kgalinec/macro-pad/production/Macro_Pad/Transcode Report.txt

   ---- Transcoding 'D:\Nextcloud\Electronics\KiCad\Macro Pad\production\Macro_Pad\Macro Pad-PTH.drl' ----   Thu Jun 26 19:38:50 2025

T2   --> T11
T8   --> T12
-----------------------------------------------------------------
