kgalinec/macro-pad/plots/Macro Pad__Assembly.pdf

ENC202 | ENC203 | H¹⁰¹ H201 | H202 H204 LED¹⁰² | LED¹⁰¹ | SW210 SW202 SW208 | SW203 SW205 | SW209 SW206 SW201 | SW207 SW204 1 | 2 | 3 | 4 | 5 | 6 1 | 2 | 3 | 4 | 5 | 6 ABCD | ABCD Date: KiCad | E.D.A. 9.0.2 Size: A4 | Rev:
ENC201 MountingHole_Pad H203 | HS91L02W2C01 OLED201 ENC202 | ENC203 | Header-Male⁻2.54_1x3 H¹⁰¹ MountingHole_Pad H202 MountingHole_Pad H201 | MountingHole_Pad H204 LED¹⁰² | LED¹⁰¹ | MX_Cherry SW210 MX_Cherry SW202 MX_Cherry SW208 | MX_Cherry SW203 MX_Cherry SW205 | MX_Cherry SW209 MX_Cherry SW206 MX_Cherry SW201 | MX_Cherry SW207 MX_Cherry SW204

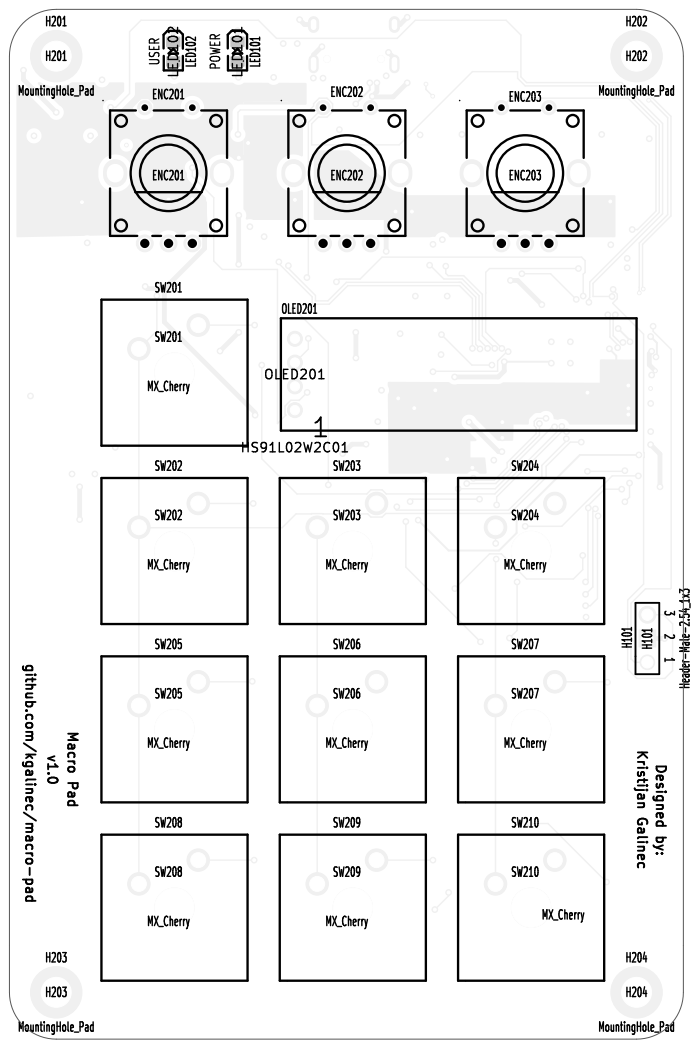
[picture p1: page 1]
Id: /1 Title: File: Macro; Pad.kicad_pcb Sheet: Black; And; White; TOP; Board2Pdf:; Black; TOP -; Page

3 2 1 Macro Pad v1.0 USER Kristijan Galinec github.com/kgalinec/macro-pad POWER Designed by: ENC201 H203 OLED2011

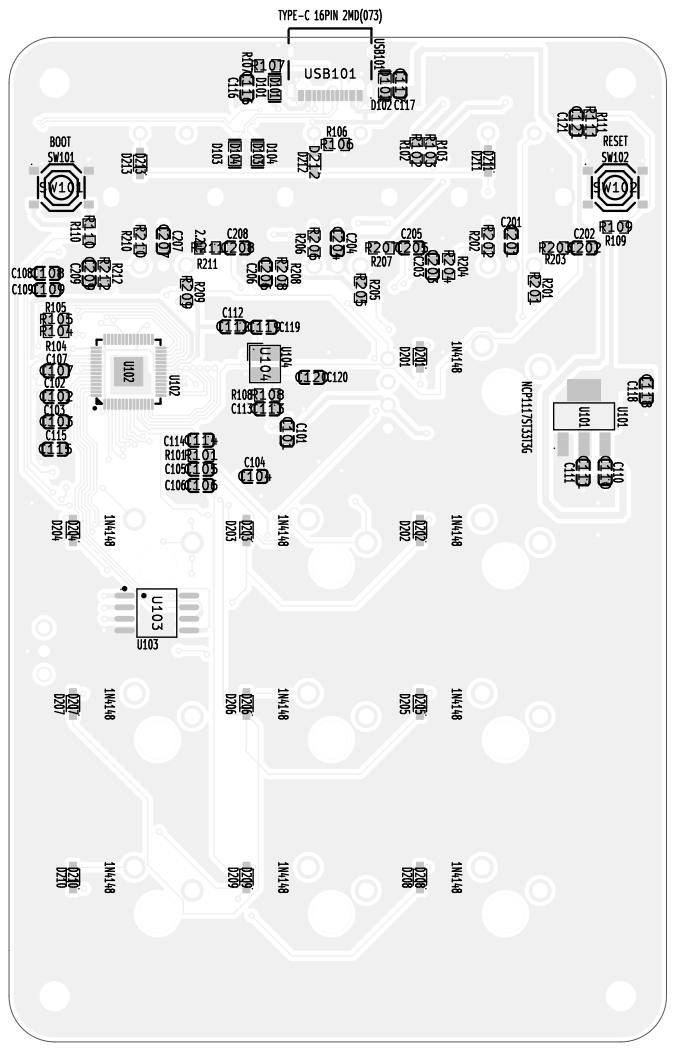
[picture p2: page 2]
