kgalinec/macro-pad/Macro Pad.pdf

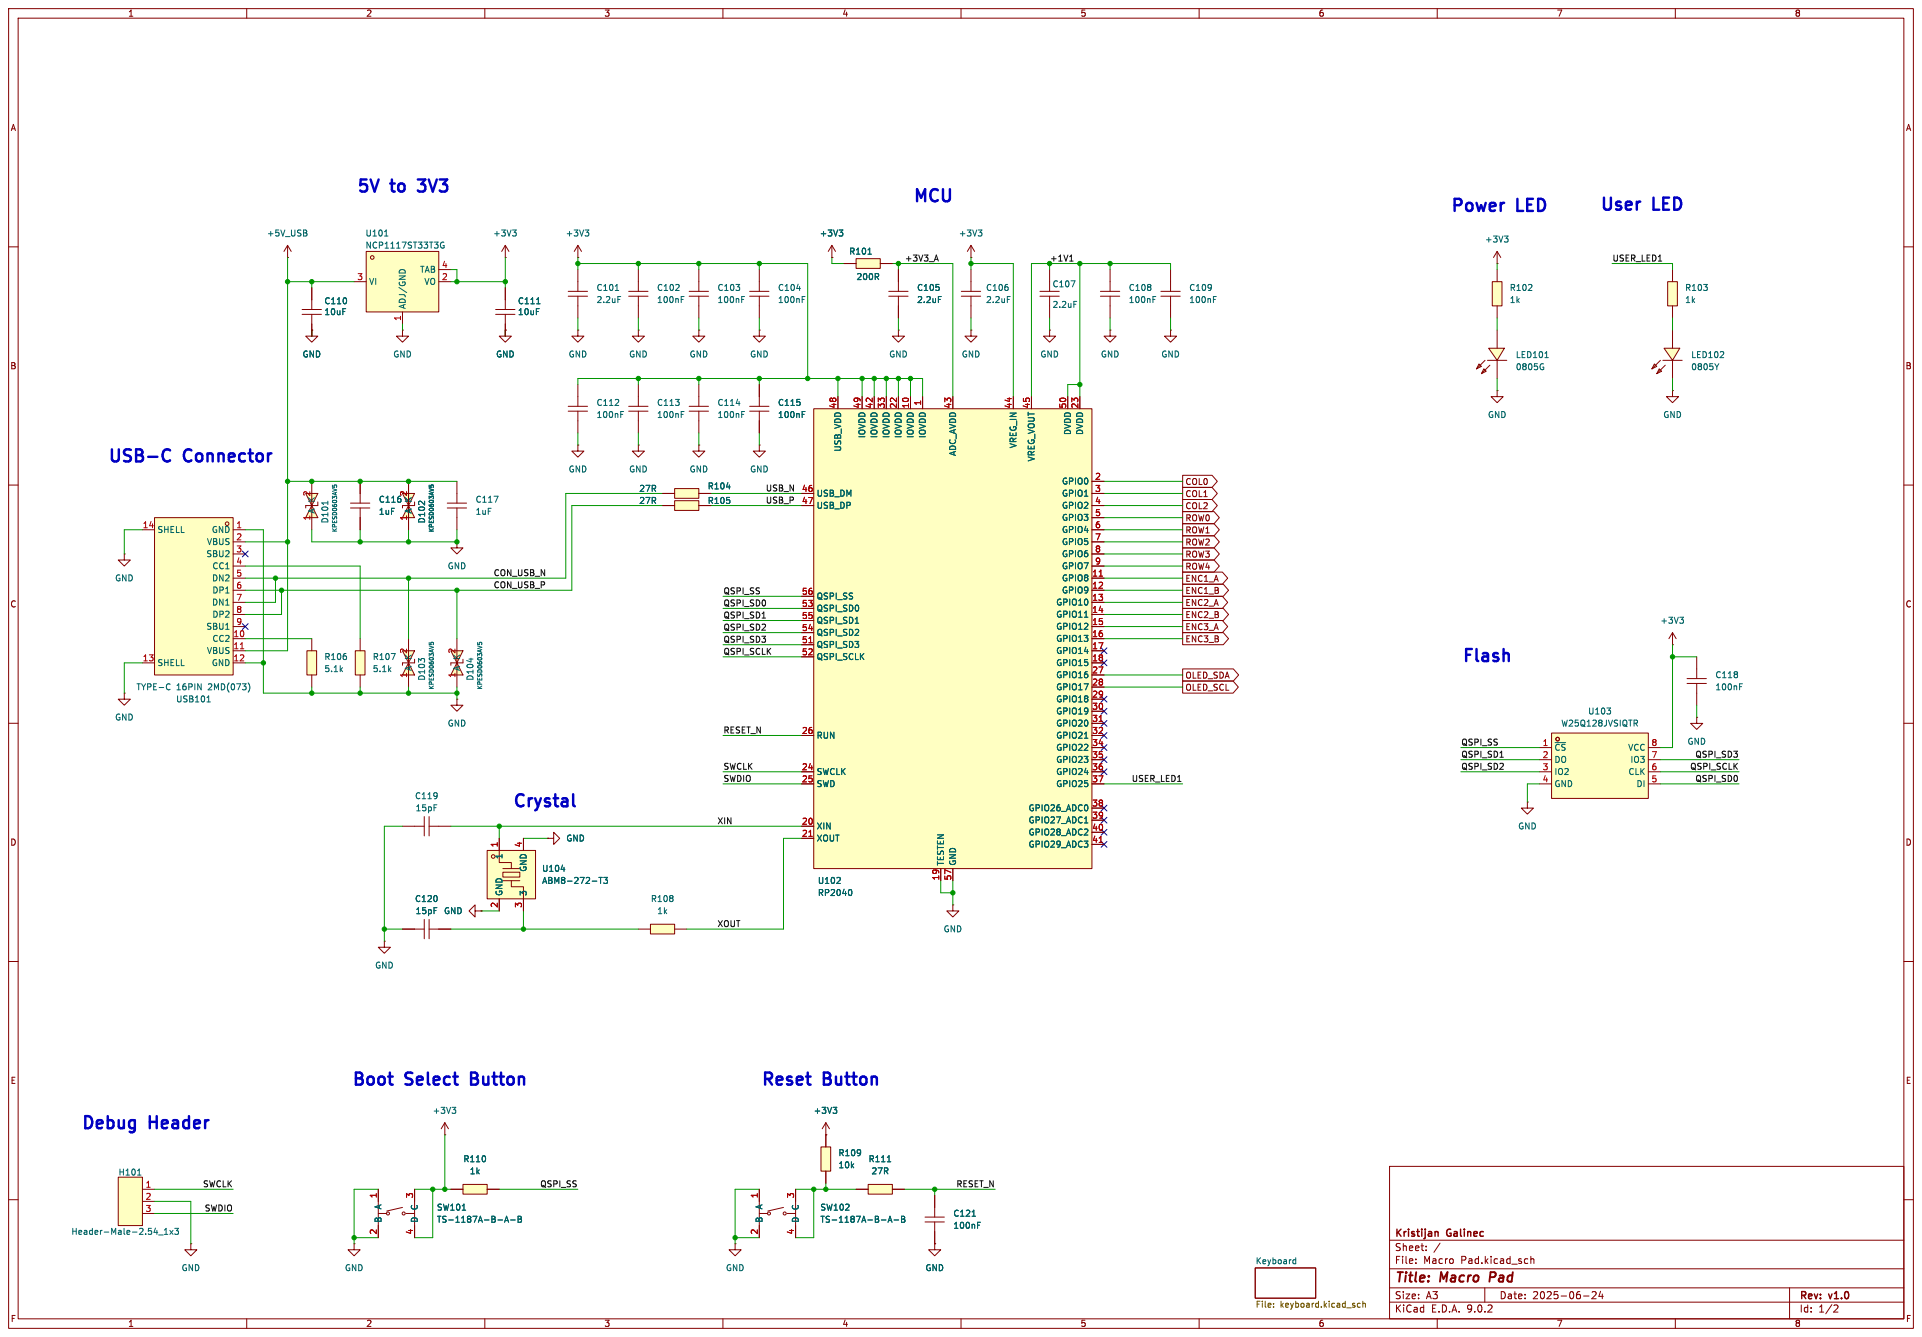
[picture p3: page 1]

1 TESTEN 19 ADC_AVDD 43 GND 57 VREG_IN 44 VREG_VOUT45 DVDD 50 DVDD 23 GPIO0 2 GPIO1 3 GPIO2 4 GPIO3 5 GPIO4 6 GPIO5 7 GPIO6 8 GPIO7 9 GPIO8 11 GPIO9 12 GPIO10 13 GPIO11 14 GPIO12 15 GPIO13 16 GPIO14 17 GPIO15 18 GPIO16 27 GPIO17 28 GPIO18 29 GPIO19 30 GPIO20 31 GPIO21 32 GPIO22 34 GPIO23 35 GPIO24 36 GPIO25 37 GPIO26_ADC0 38 GPIO27_ADC1 39 GPIO28_ADC2 40 GPIO29_ADC3 41 U102 RP2040

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

Id: 1/2 Title: Macro Pad

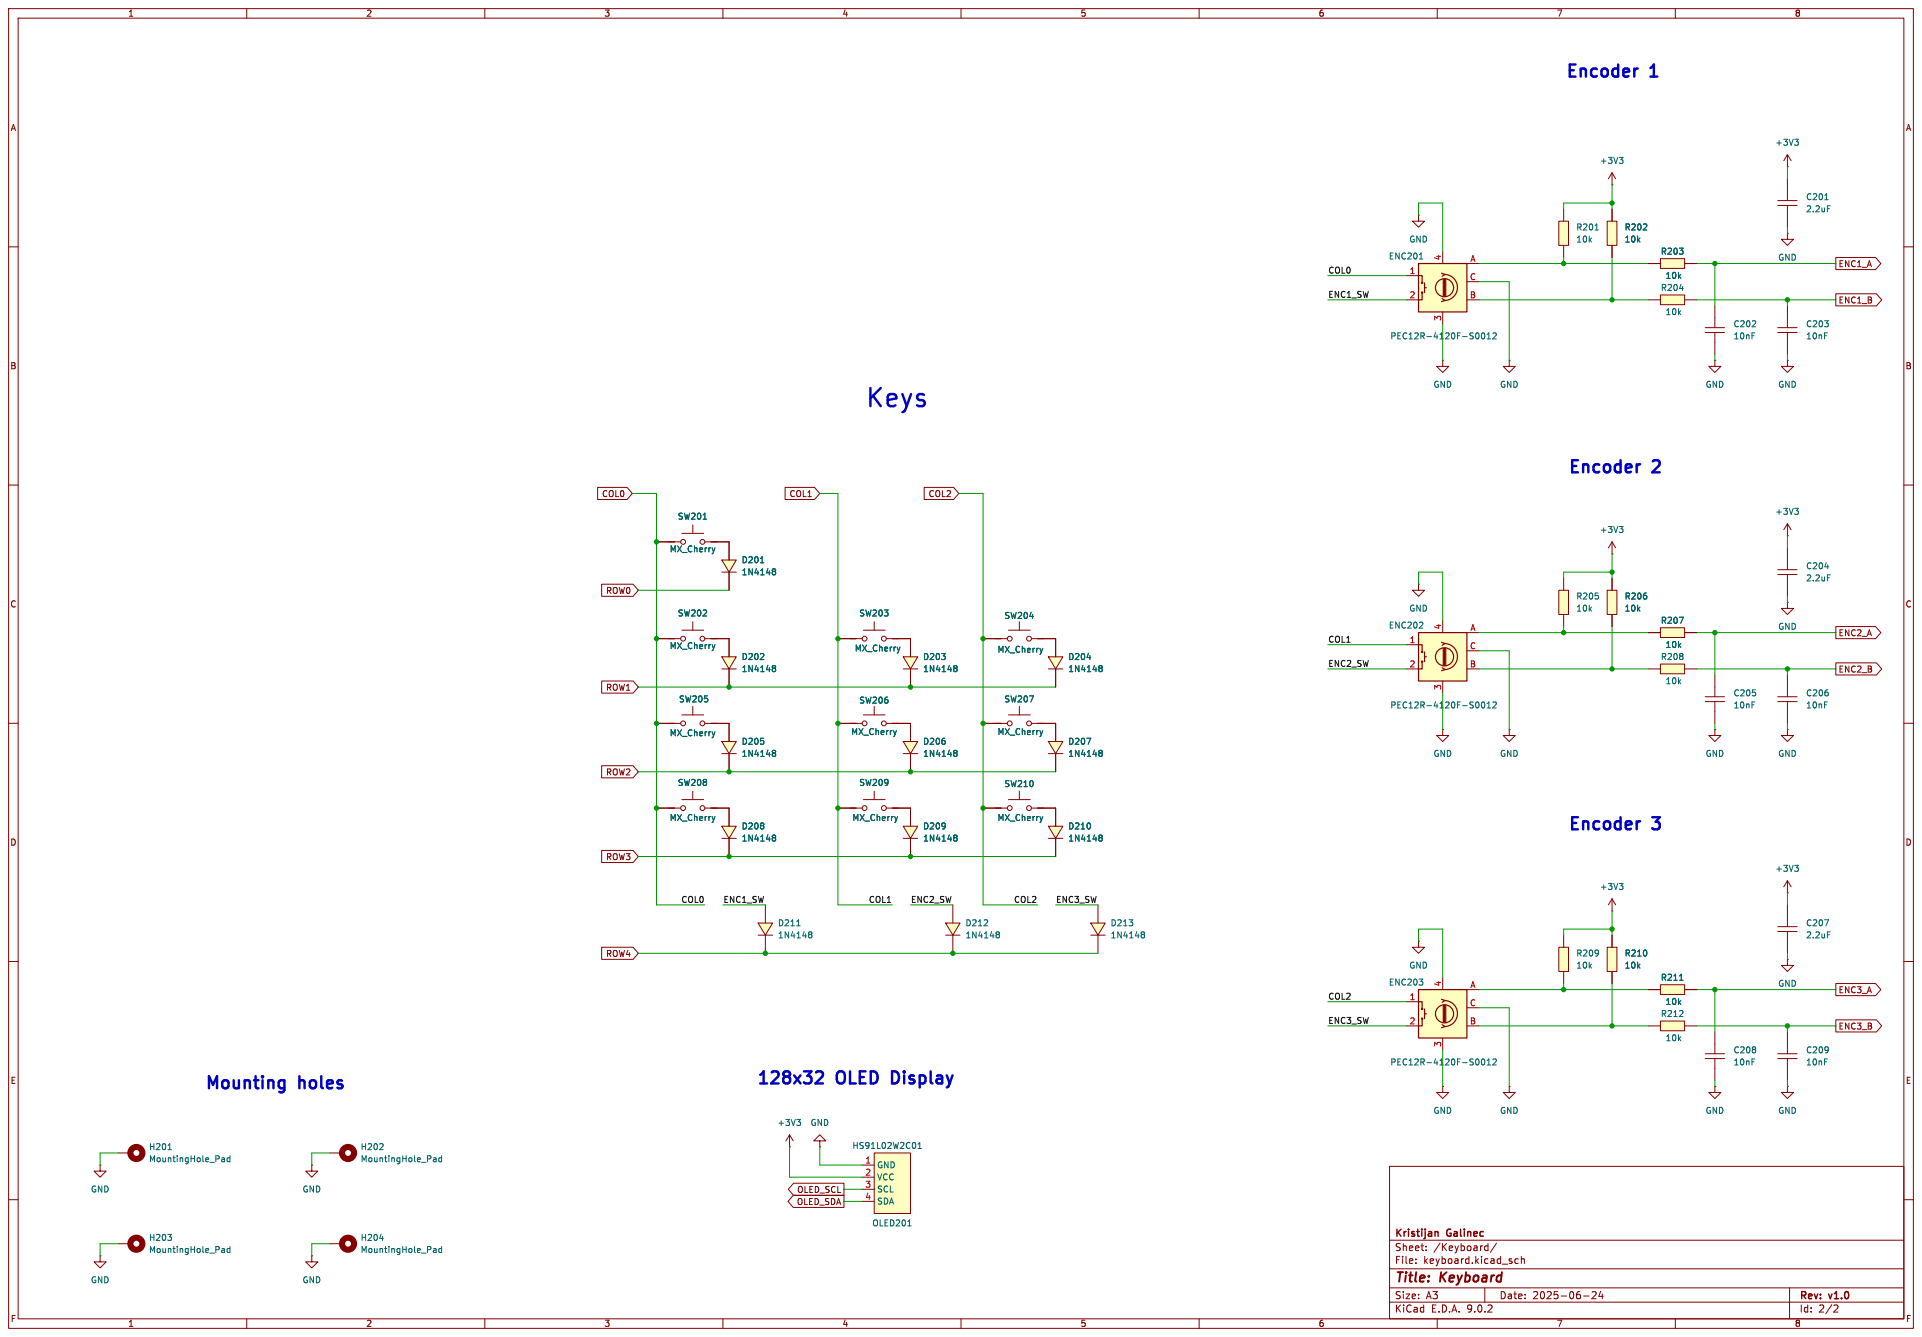
[picture p4: page 2]

SDA 4 SCL 3 VCC 2 GND 1 OLED201 HS91L02W2C01 GND
