kgalinec/macro-pad/Macro Pad-B_Cu.pdf

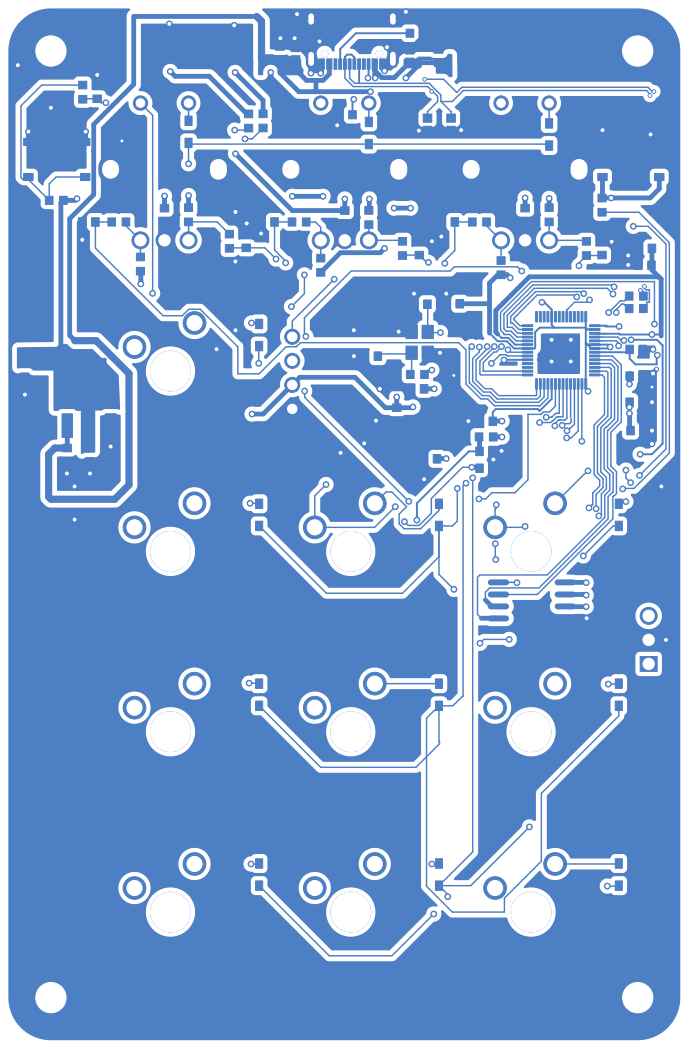
[picture p5: page 1]
