kgalinec/macro-pad/Macro Pad-B_Mask.pdf

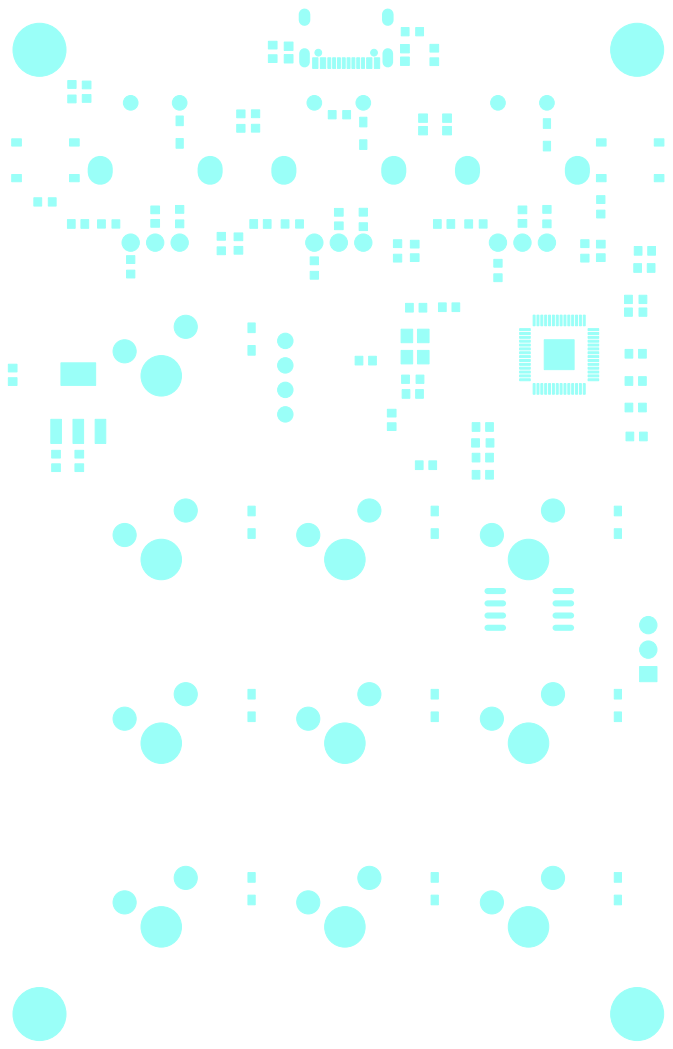
[picture p6: page 1]
