kgalinec/macro-pad/Macro Pad-B_Paste.pdf

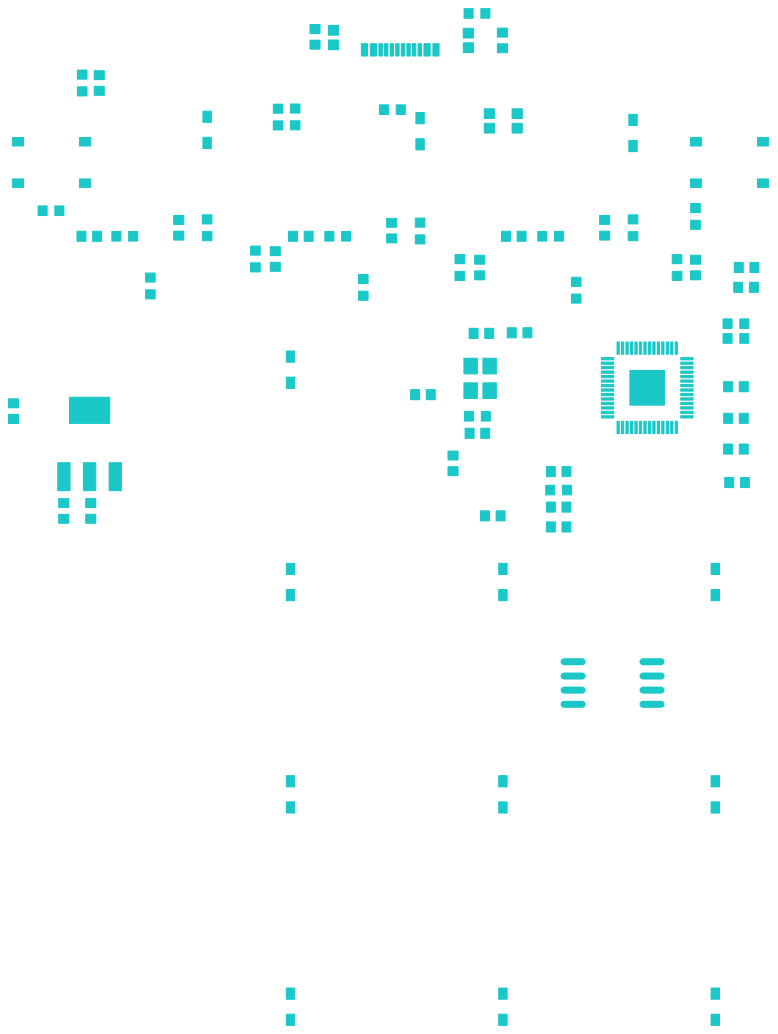
[picture p7: page 1]
