kgalinec/macro-pad/Macro Pad-B_Silkscreen.pdf

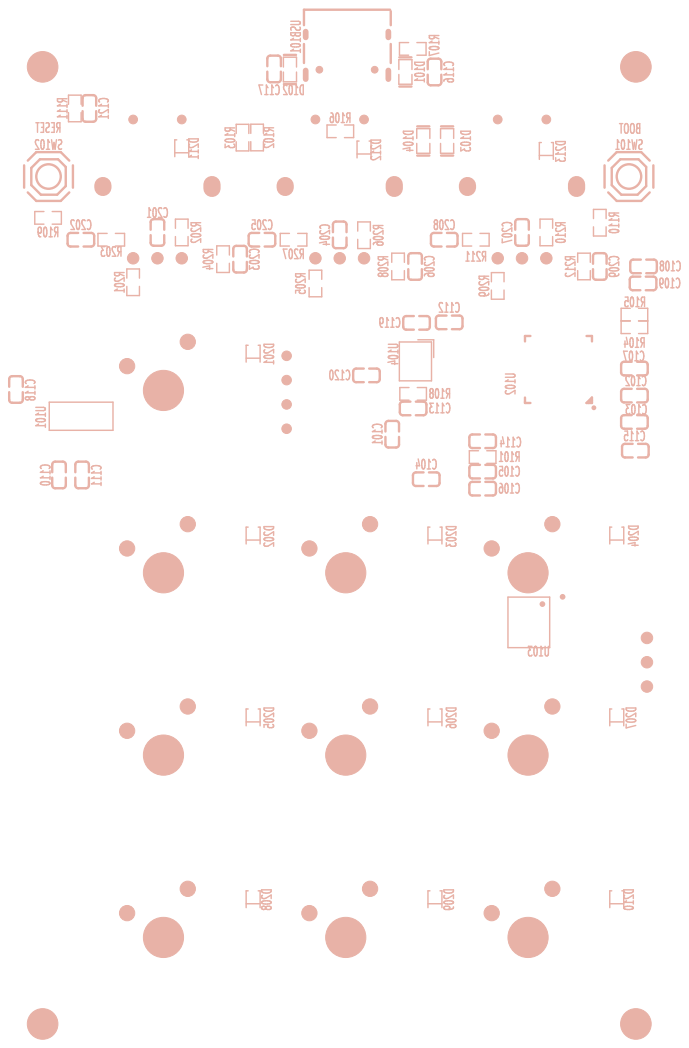
[picture p8: page 1]
