kgalinec/macro-pad/Macro Pad-Edge_Cuts.pdf

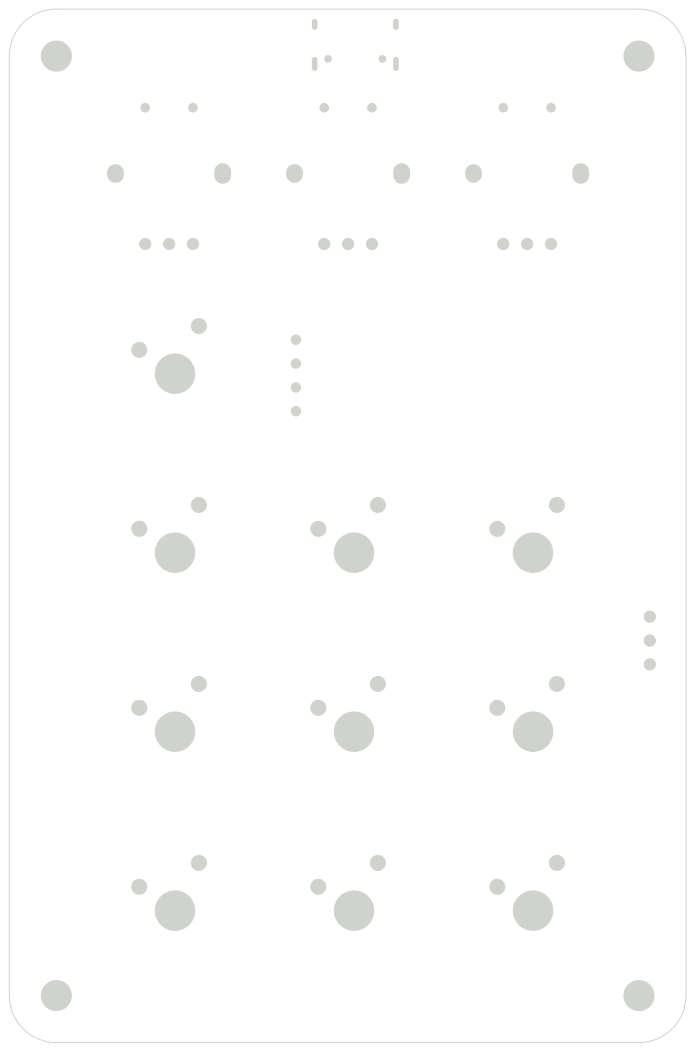
[picture p9: page 1]
