kgalinec/macro-pad/Macro Pad-F_Cu.pdf

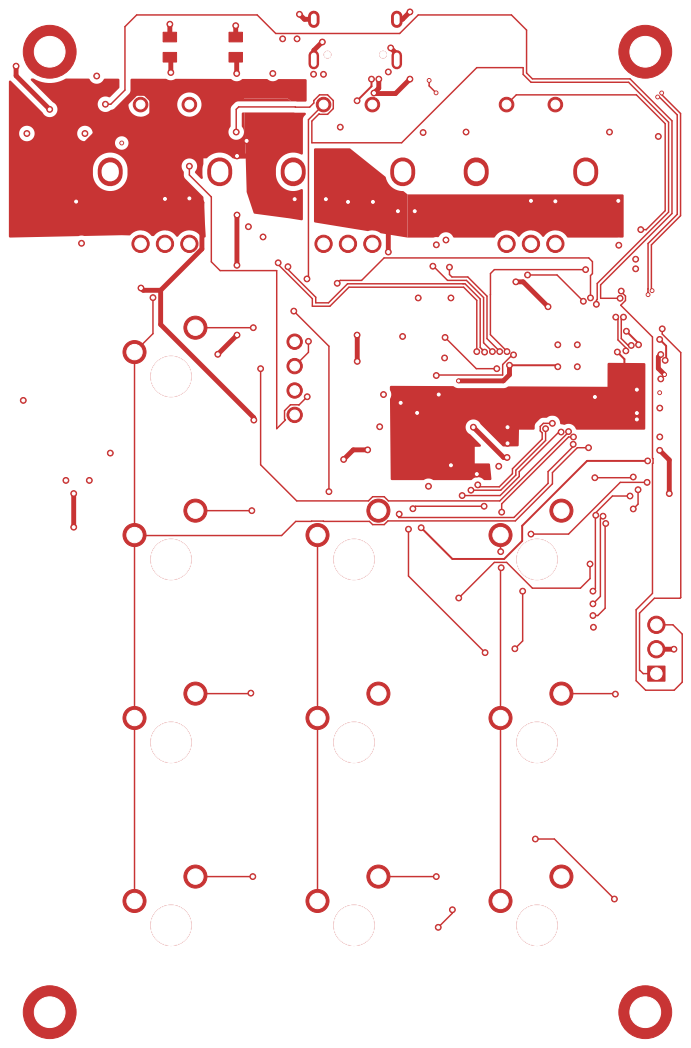
[picture p10: page 1]
