kgalinec/macro-pad/Macro Pad-F_Mask.pdf

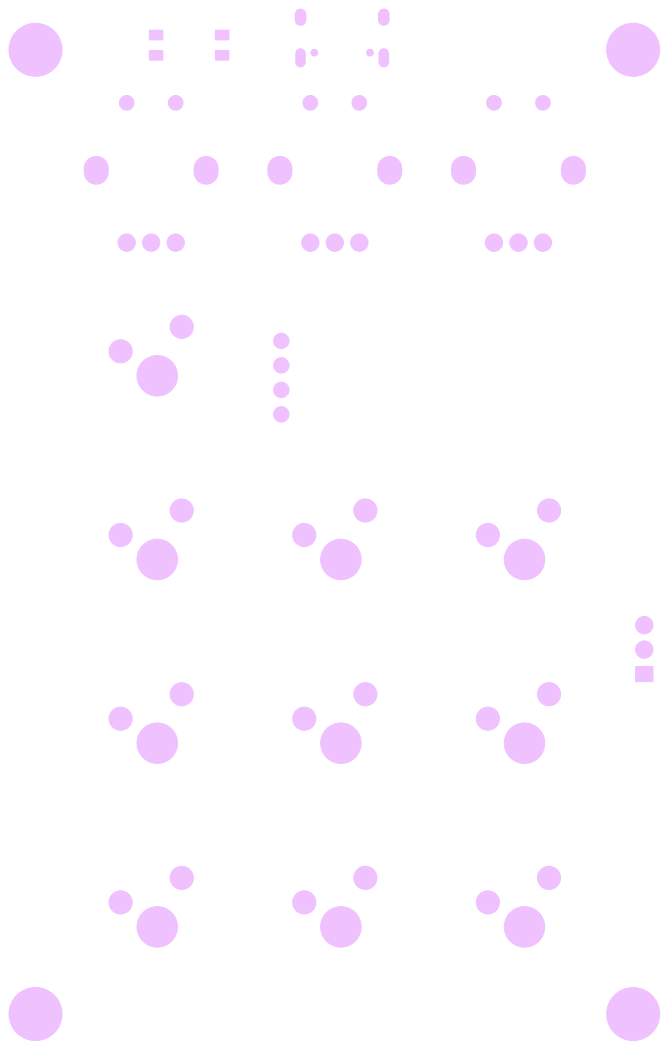
[picture p11: page 1]
