kgalinec/macro-pad/(list of files, drawings)

Other design files:
freerouting.dsn
