kgalinec/macro-pad/Macro Pad.kicad_pcb

## KiCad design Macro Pad.kicad_pcb (2026-02-02)

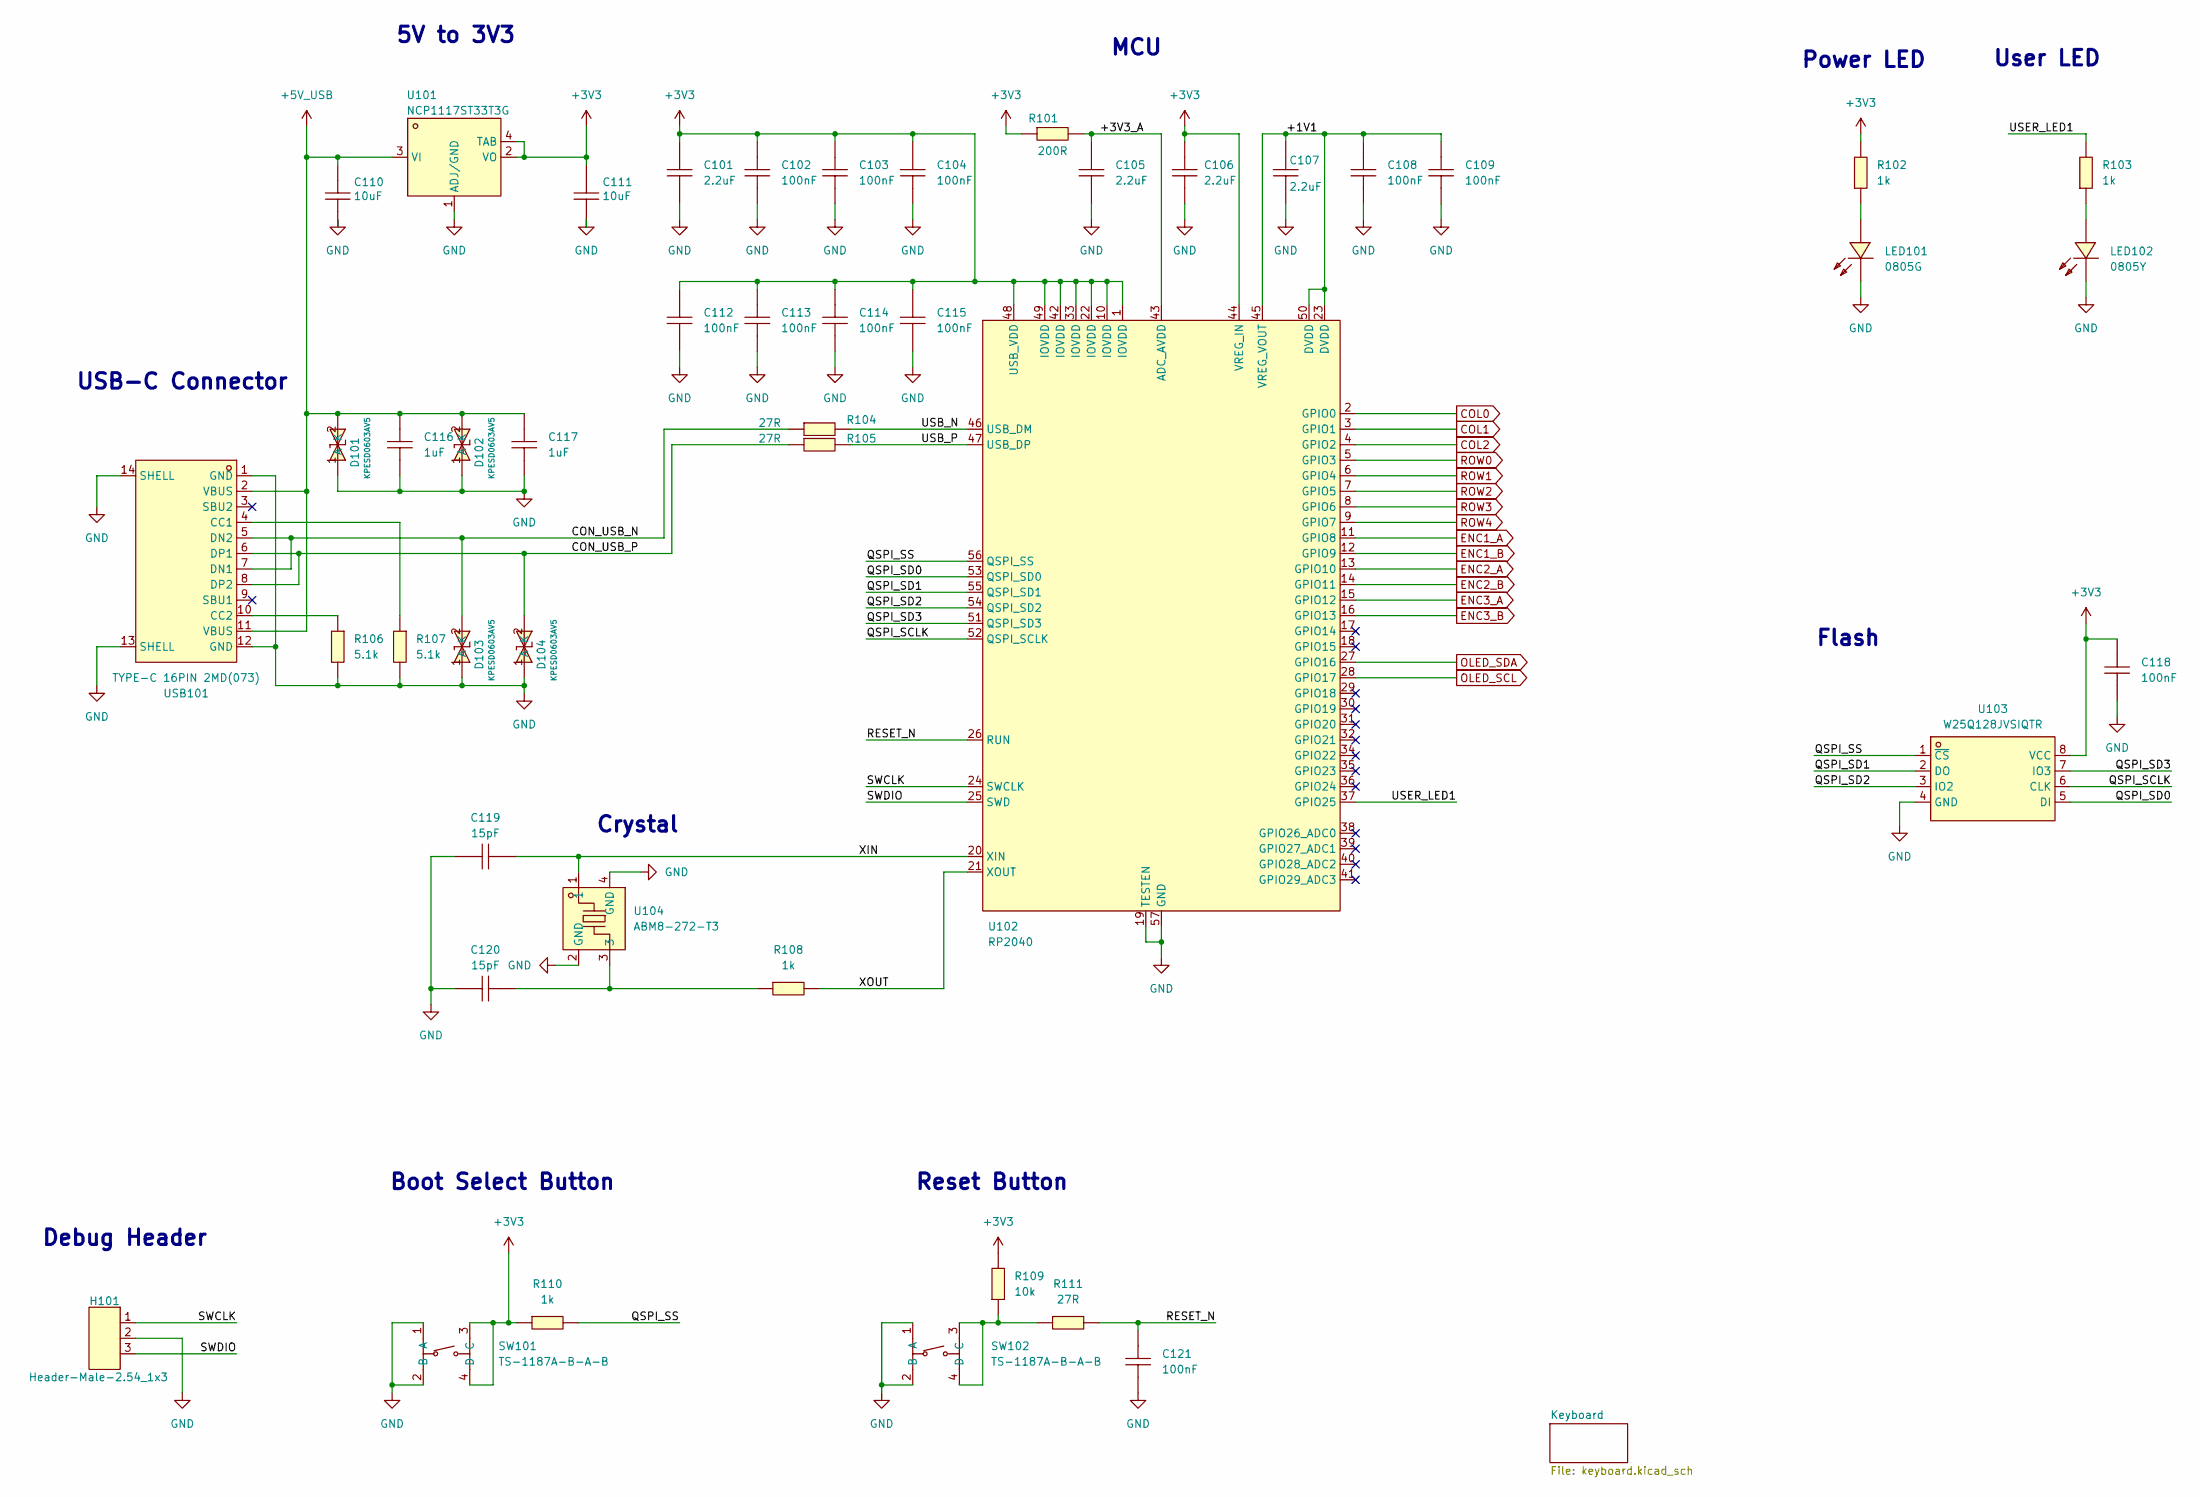
[picture p12: schematic Macro Pad.kicad_sch]

Parts:
C101, C105, C106, C107: 2.2uF; C0603; LCSC Part C23630
C102, C103, C104, C108, C109, C112, C113, C114, C115, C118, C121: 100nF; C0603; LCSC Part C1591
C110, C111: 10uF; C0603; LCSC Part C1691
C116, C117: 1uF; C0603; LCSC Part C15849
C119, C120: 15pF; C0603; LCSC Part C1644
D101, D102, D103, D104: KPESD0603AV5; D0603-BI-A; LCSC Part C2944167
H101: Header-Male-2.54_1x3; HDR-TH_3P-P2.54-V-M-1; LCSC Part C49257
LED101: 0805G; LED0805-R-RD; LCSC Part C2297
LED102: 0805Y; LED0805-R-RD; LCSC Part C2296
R101: 200R; R0603; LCSC Part C8218
R102, R103, R108, R110: 1k; R0603; LCSC Part C21190
R104, R105, R111: 27R; R0603; LCSC Part C25190
R106, R107: 5.1k; R0603; LCSC Part C23186
R109: 10k; R0603; LCSC Part C25804
SW101, SW102: TS-1187A-B-A-B; SW-SMD_4P-L5.1-W5.1-P3.70-LS6.5-TL_H1.5; LCSC Part C318884
U101: NCP1117ST33T3G; SOT-223-3_L6.5-W3.4-P2.30-LS7.0-BR; LCSC Part C26537
U102: RP2040; LQFN-56_L7.0-W7.0-P0.4-EP; LCSC Part C2040
U103: W25Q128JVSIQTR; SOIC-8_L5.3-W5.3-P1.27-LS8.0-BL; LCSC Part C97521
U104: ABM8-272-T3; CRYSTAL-SMD_4P-L3.2-W2.5-BL; LCSC Part C20625731
USB101: TYPE-C 16PIN 2MD(073); USB-C-SMD_TYPE-C-6PIN-2MD-073; LCSC Part C2765186

Connections:
+3V3: C101.2, C102.2, C103.2, C104.2, C106.2, C111.2, C112.2, C113.2, C114.2, C115.2, C118.2, R101.1, R102.2, R109.2, R110.1, SW101.3 (C), SW101.4 (D), U101.2 (VO), U101.4 (TAB), U102.1 (IOVDD), U102.10 (IOVDD), U102.22 (IOVDD), U102.33 (IOVDD), U102.42 (IOVDD), U102.44 (VREG_IN), U102.48 (USB_VDD), U102.49 (IOVDD), U103.8 (VCC); also elsewhere on the board
+5V_USB: C110.2, C116.2, C117.2, D101.2 (A), D102.2 (A), U101.3 (VI), USB101.2 (VBUS), USB101.11 (VBUS)
/+1V1: C107.2, C108.2, C109.2, U102.23 (DVDD), U102.45 (VREG_VOUT), U102.50 (DVDD)
/+3V3_A: C105.2, R101.2, U102.43 (ADC_AVDD)
/CON_USB_N: D103.2 (A), R104.1, USB101.5 (DN2), USB101.7 (DN1)
/CON_USB_P: D104.2 (A), R105.1, USB101.6 (DP1), USB101.8 (DP2)
/QSPI_SCLK: U102.52 (QSPI_SCLK), U103.6 (CLK)
/QSPI_SD0: U102.53 (QSPI_SD0), U103.5 (DI)
/QSPI_SD1: U102.55 (QSPI_SD1), U103.2 (DO)
/QSPI_SD2: U102.54 (QSPI_SD2), U103.3 (IO2)
/QSPI_SD3: U102.51 (QSPI_SD3), U103.7 (IO3)
/QSPI_SS: R110.2, U102.56 (QSPI_SS), U103.1 (~CS)
/RESET_N: C121.2, R111.2, U102.26 (RUN)
/SWCLK: H101.1, U102.24 (SWCLK)
/SWDIO: H101.3, U102.25 (SWD)
/USB_N: R104.2, U102.46 (USB_DM)
/USB_P: R105.2, U102.47 (USB_DP)
/USER_LED1: R103.2, U102.37 (GPIO25)
/XIN: C119.1, U102.20 (XIN), U104.1
/XOUT: R108.2, U102.21 (XOUT)
COL0: U102.2 (GPIO0); also elsewhere on the board
COL1: U102.3 (GPIO1); also elsewhere on the board
COL2: U102.4 (GPIO2); also elsewhere on the board
ENC1_A: U102.11 (GPIO8); also elsewhere on the board
ENC1_B: U102.12 (GPIO9); also elsewhere on the board
ENC2_A: U102.13 (GPIO10); also elsewhere on the board
ENC2_B: U102.14 (GPIO11); also elsewhere on the board
ENC3_A: U102.15 (GPIO12); also elsewhere on the board
ENC3_B: U102.16 (GPIO13); also elsewhere on the board
GND: C101.1, C102.1, C103.1, C104.1, C105.1, C106.1, C107.1, C108.1, C109.1, C110.1, C111.1, C112.1, C113.1, C114.1, C115.1, C116.1, C117.1, C118.1, C119.2, C120.2, C121.1, D101.1 (K), D102.1 (K), D103.1 (K), D104.1 (K), H101.2, LED101.2 (K), LED102.2 (K), R106.2, R107.2, SW101.1 (A), SW101.2 (B), SW102.1 (A), SW102.2 (B), U101.1 (ADJ/GND), U102.19 (TESTEN), U102.57 (GND), U103.4 (GND), U104.2 (GND), U104.4 (GND), USB101.1 (GND), USB101.12 (GND), USB101.13 (SHELL), USB101.14 (SHELL); also elsewhere on the board
unnamed: C120.1, R108.1, U104.3
unnamed: LED101.1 (A), R102.1
unnamed: LED102.1 (A), R103.1
unnamed: R109.1, R111.1, SW102.3 (C), SW102.4 (D)
unnamed: R107.1, USB101.4 (CC1)
unnamed: R106.1, USB101.10 (CC2)
OLED_SCL: U102.28 (GPIO17); also elsewhere on the board
OLED_SDA: U102.27 (GPIO16); also elsewhere on the board
ROW0: U102.5 (GPIO3); also elsewhere on the board
ROW1: U102.6 (GPIO4); also elsewhere on the board
ROW2: U102.7 (GPIO5); also elsewhere on the board
ROW3: U102.8 (GPIO6); also elsewhere on the board
ROW4: U102.9 (GPIO7); also elsewhere on the board

Notes on the sheet:
MCU
Crystal
Power LED
Boot Select Button
Debug Header
Flash
Reset Button
5V to 3V3
USB-C Connector
User LED

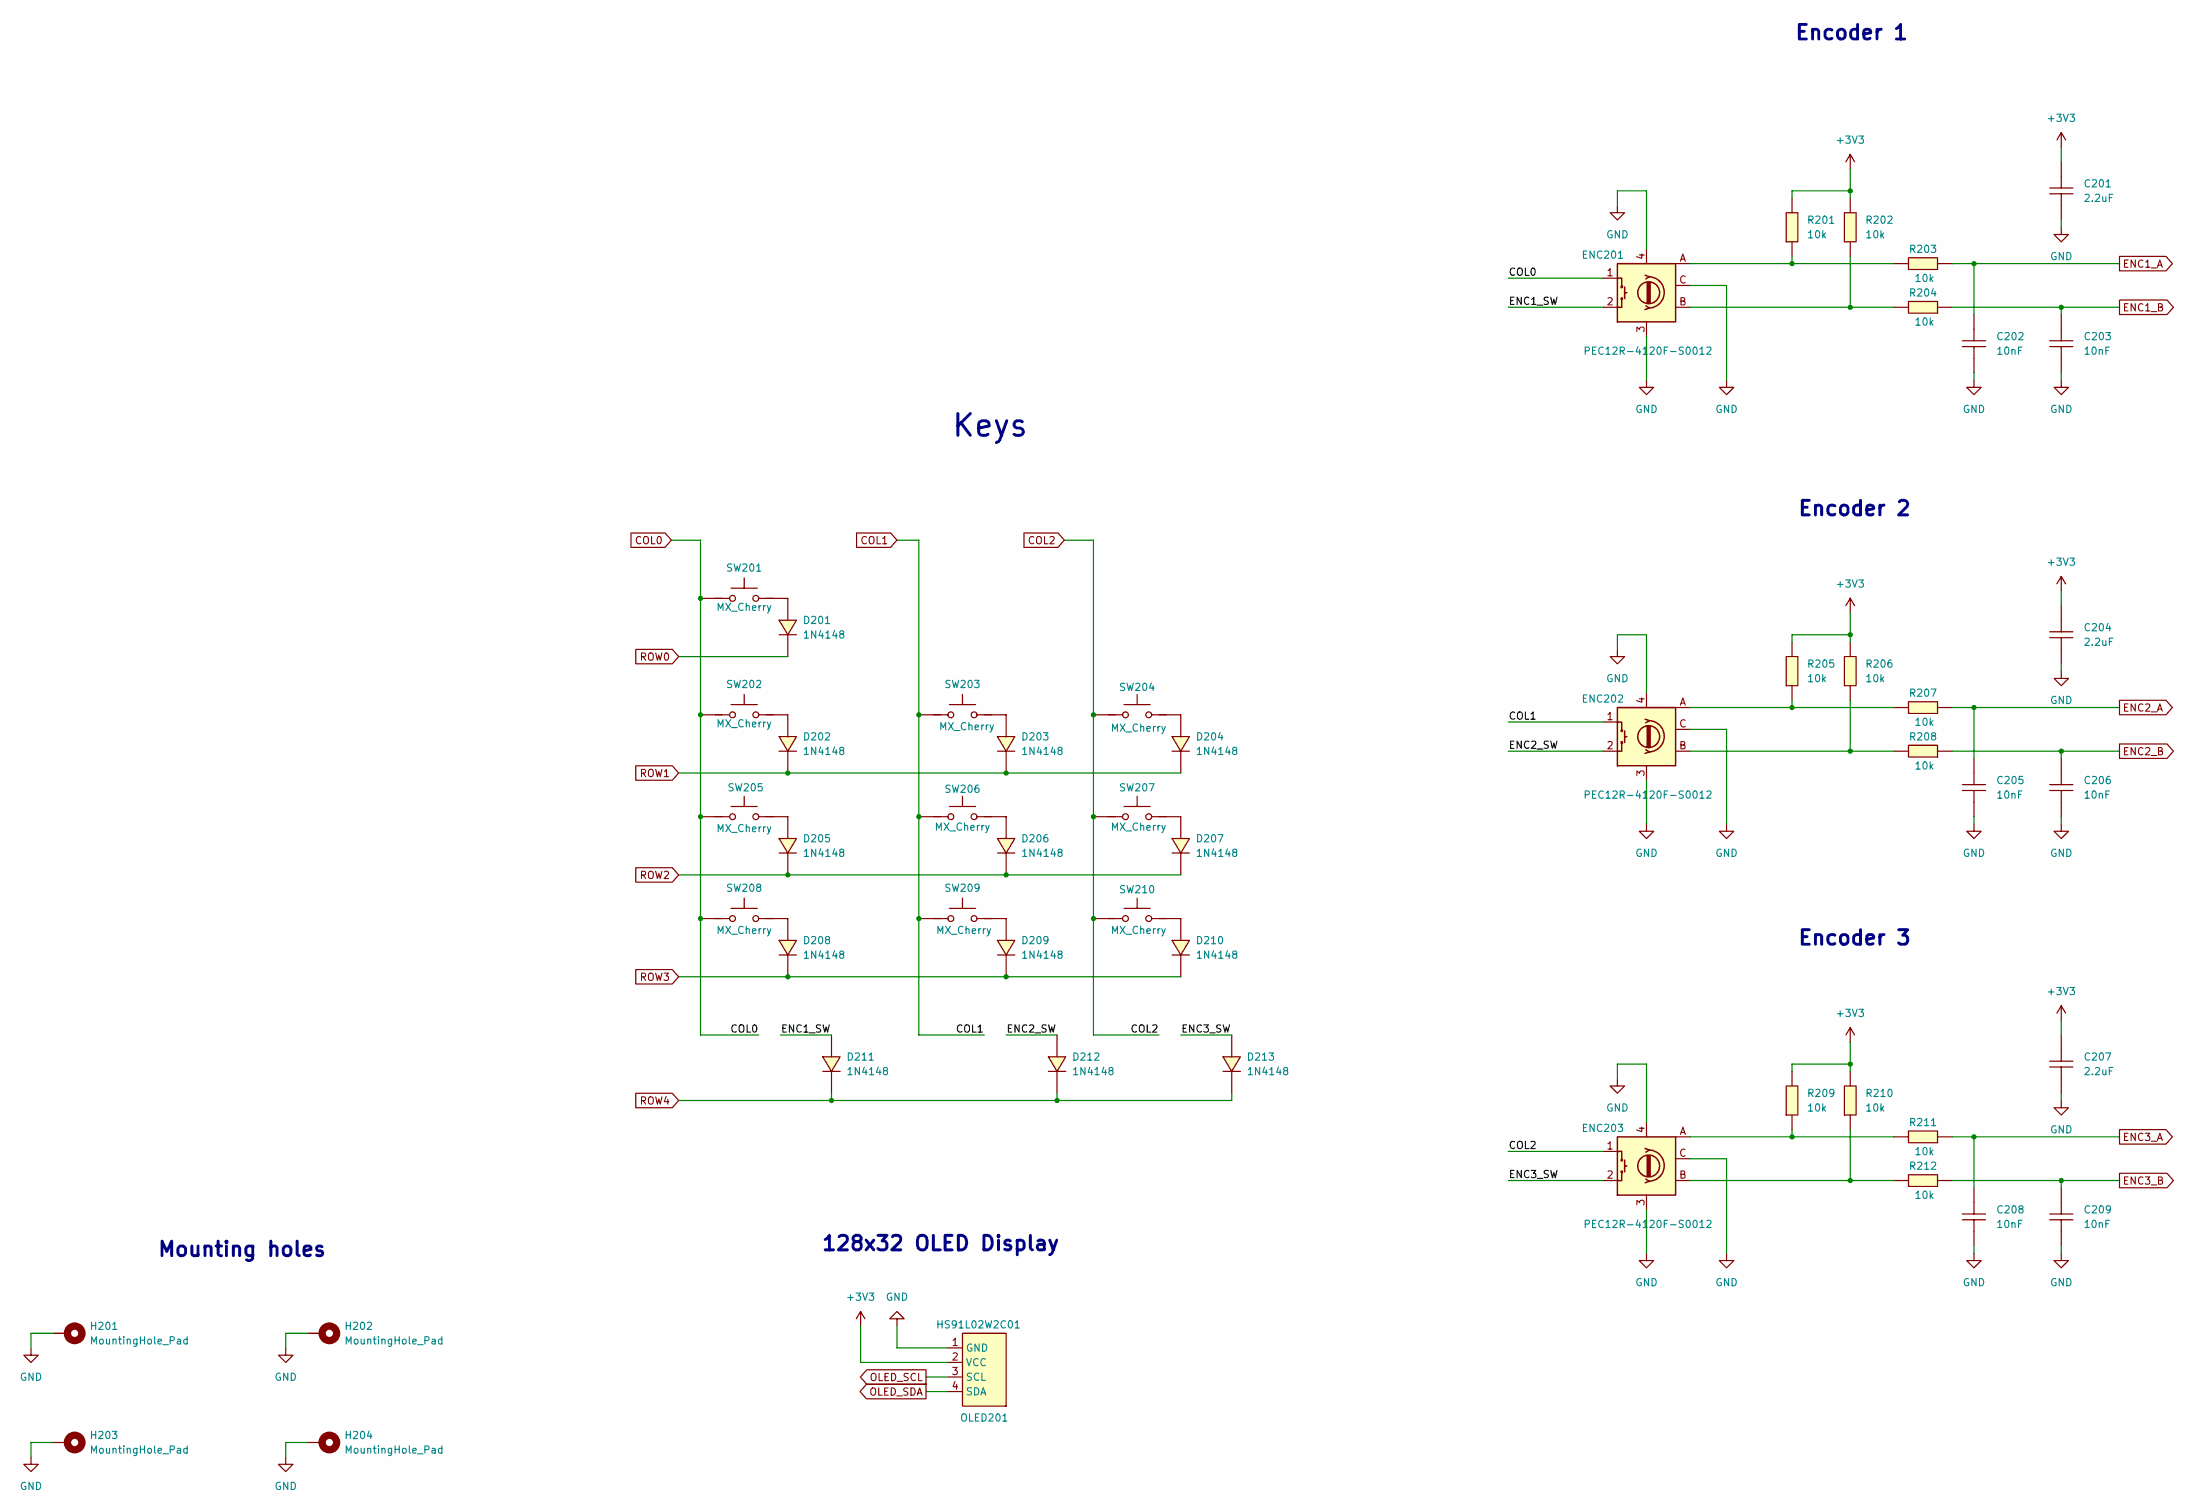
[picture p13: schematic keyboard.kicad_sch]

Parts:
C201, C204, C207: 2.2uF; C0603; LCSC Part C23630
C202, C203, C205, C206, C208, C209: 10nF; C0603; LCSC Part C1589
D201, D202, D203, D204, D205, D206, D207, D208, D209, D210, D211, D212, D213: 1N4148; SOD-323_L1.8-W1.3-LS2.5-RD; LCSC Part C2128
ENC201, ENC202, ENC203: PEC12R-4120F-S0012; SW-TH_PEC12R-4120F-S0012; LCSC Part C143801
H201, H202, H203, H204: MountingHole_Pad; MountingHole_3.2mm_M3_ISO14580_Pad
OLED201: HS91L02W2C01; OLED-TH_L38.0-W12.0_HS91L02W2C01; LCSC Part C5248081
R201, R202, R203, R204, R205, R206, R207, R208, R209, R210, R211, R212: 10k; R0603; LCSC Part C25804
SW201, SW202, SW203, SW204, SW206, SW207, SW208, SW209, SW210: MX_Cherry; KEY-TH_CPG151101D21X; LCSC Part C400235
SW205: MX_Cherry; KEY-TH_CPG151101D21X

Connections:
+3V3: C201.2, C204.2, C207.2, OLED201.2 (VCC), R201.2, R202.2, R205.2, R206.2, R209.2, R210.2; also elsewhere on the board
/Keyboard/ENC1_SW: D211.2 (A), ENC201.2
/Keyboard/ENC2_SW: D212.2 (A), ENC202.2
/Keyboard/ENC3_SW: D213.2 (A), ENC203.2
COL0: ENC201.1, SW201.1, SW202.1, SW205.1, SW208.1; also elsewhere on the board
COL1: ENC202.1, SW203.1, SW206.1, SW209.1; also elsewhere on the board
COL2: ENC203.1, SW204.1, SW207.1, SW210.1; also elsewhere on the board
ENC1_A: C202.2, R203.1; also elsewhere on the board
ENC1_B: C203.2, R204.1; also elsewhere on the board
ENC2_A: C205.2, R207.1; also elsewhere on the board
ENC2_B: C206.2, R208.1; also elsewhere on the board
ENC3_A: C208.2, R211.1; also elsewhere on the board
ENC3_B: C209.2, R212.1; also elsewhere on the board
GND: C201.1, C202.1, C203.1, C204.1, C205.1, C206.1, C207.1, C208.1, C209.1, ENC201.3, ENC201.4, ENC201.C, ENC202.3, ENC202.4, ENC202.C, ENC203.3, ENC203.4, ENC203.C, H201.1, H202.1, H203.1, H204.1, OLED201.1 (GND); also elsewhere on the board
unnamed: D201.2 (A), SW201.2
unnamed: D202.2 (A), SW202.2
unnamed: D203.2 (A), SW203.2
unnamed: D204.2 (A), SW204.2
unnamed: D205.2 (A), SW205.2
unnamed: D206.2 (A), SW206.2
unnamed: D207.2 (A), SW207.2
unnamed: D208.2 (A), SW208.2
unnamed: D209.2 (A), SW209.2
unnamed: D210.2 (A), SW210.2
unnamed: ENC201.A, R201.1, R203.2
unnamed: ENC201.B, R202.1, R204.2
unnamed: ENC202.A, R205.1, R207.2
unnamed: ENC202.B, R206.1, R208.2
unnamed: ENC203.A, R209.1, R211.2
unnamed: ENC203.B, R210.1, R212.2
OLED_SCL: OLED201.3 (SCL); also elsewhere on the board
OLED_SDA: OLED201.4 (SDA); also elsewhere on the board
ROW0: D201.1 (K); also elsewhere on the board
ROW1: D202.1 (K), D203.1 (K), D204.1 (K); also elsewhere on the board
ROW2: D205.1 (K), D206.1 (K), D207.1 (K); also elsewhere on the board
ROW3: D208.1 (K), D209.1 (K), D210.1 (K); also elsewhere on the board
ROW4: D211.1 (K), D212.1 (K), D213.1 (K); also elsewhere on the board

Notes on the sheet:
Encoder 2
Encoder 3
Encoder 1
Mounting holes
128x32 OLED Display
Keys

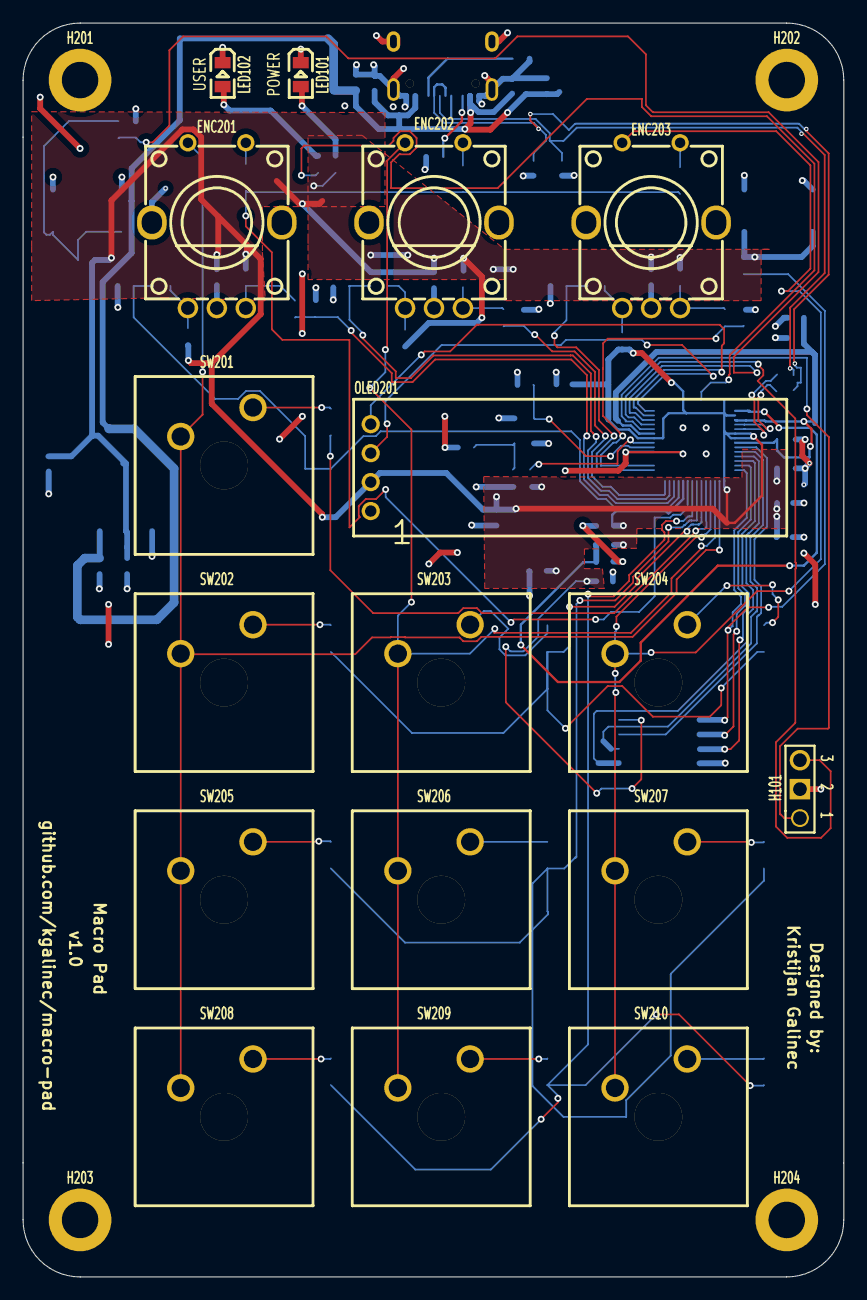
[picture p14: board Macro Pad.kicad_pcb from above]

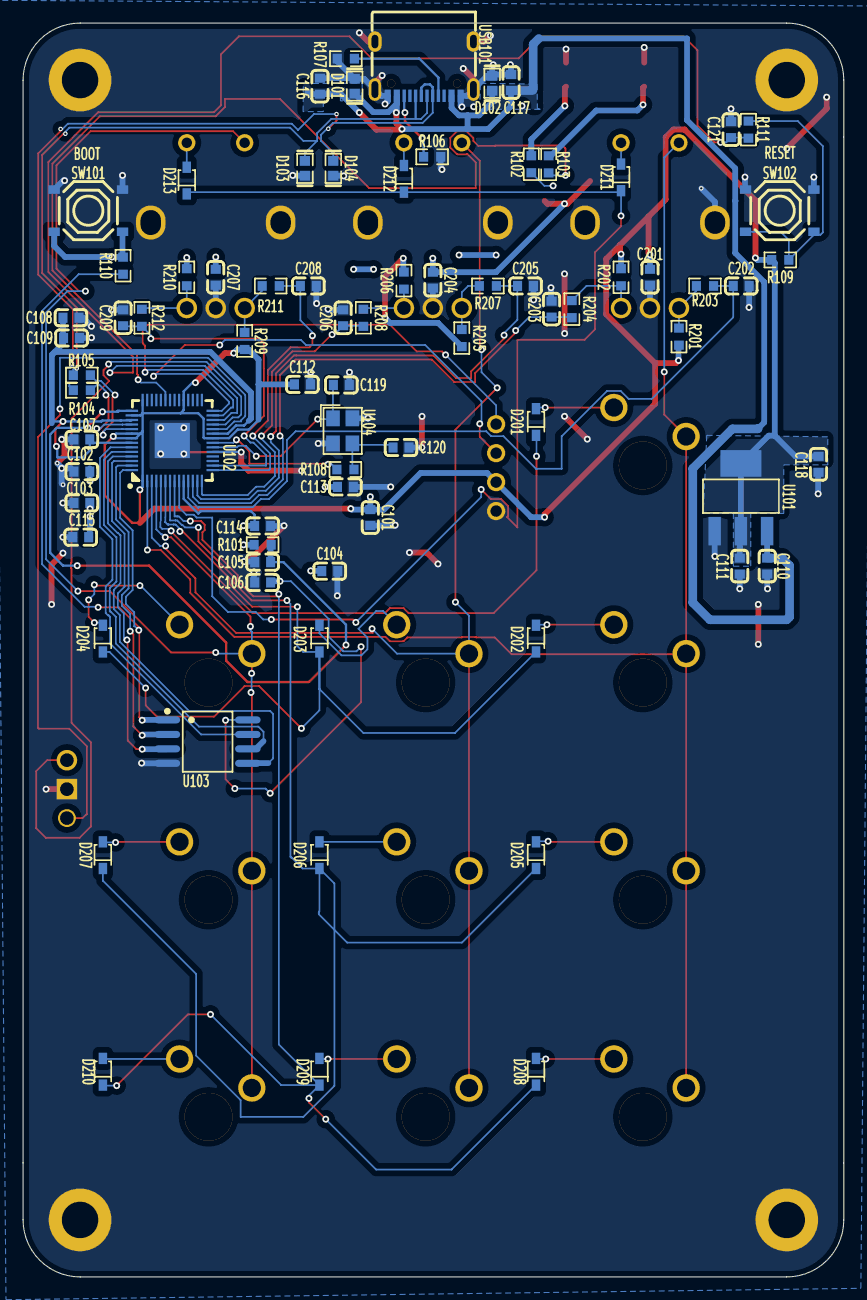
[picture p15: board Macro Pad.kicad_pcb from below]

Board: 2 copper layers, 72.0 x 110.0 mm, 98 parts (77 on the bottom side), 62 nets.
